shreyaspotnis/temperature_controller/README.md

# temperature_controller
A unipolar output temperature controller
