shreyaspotnis/temperature_controller/Bill of Materials.xlsx

Description | Digikey Part Number | Quantity | Footprint | Link | Parts
Resistors
10k Low Tempco Resistor | TNPU10.0KBACT-ND | 1 | "0603" | http://www.digikey.ca/product-detail/en/vishay-dale/TNPU060310K0BZEN00/TNPU10.0KBACT-ND/2238375 | R28
10k resistor, 1% | 311-10.0KHRCT-ND | 7 | "0603" | http://www.digikey.ca/product-detail/en/yageo/RC0603FR-0710KL/311-10.0KHRCT-ND/729827 | R13,R6,R7,R12,R14,R25,R26,
5.1k Low Tempco Resistor | RG16N5.1KWCT-ND | 2 | "0603" | http://www.digikey.ca/product-detail/en/susumu/RG1608N-512-W-T1/RG16N5.1KWCT-ND/600802 | R1,R2
499k | 311-499KHRCT-ND | 2 | "0603" | http://www.digikey.ca/product-detail/en/yageo/RC0603FR-07499KL/311-499KHRCT-ND/730214 | R3,R4
100k | 311-100KHRCT-ND | 4 | "0603" | http://www.digikey.ca/product-detail/en/yageo/RC0603FR-07100KL/311-100KHRCT-ND/729836 | R5,R23,R24,R27
1M | 311-1.00MHRCT-ND | 3 | "0603" | http://www.digikey.ca/product-detail/en/yageo/RC0603FR-071ML/311-1.00MHRCT-ND/729791 | R15,R19,R21
3k | 311-3.0KGRCT-ND | 1 | "0603" | http://www.digikey.ca/product-detail/en/yageo/RC0603JR-073KL/311-3.0KGRCT-ND/729701 | R9, R16
1k | 311-1.0KGRCT-ND | 3 | "0603" | http://www.digikey.ca/product-search/en?keywords=311-1.0KGRCT-ND | R17,R22,R29
511Ohm | 311-511HRTR-ND | 2 | "0603" | http://www.digikey.ca/product-detail/en/yageo/RC0603FR-07511RL/311-511HRTR-ND/727287 | R8,R18
9.09k | 311-9.09KHRCT-ND | 1 | "0603" | http://www.digikey.ca/product-detail/en/yageo/RC0603FR-079K09L/311-9.09KHRCT-ND/730365 | R20
0.5 Ohm Sense resistor | CSRN2512FKR500CT-ND | 1 | "2512" | http://www.digikey.ca/product-detail/en/stackpole-electronics-inc/CSRN2512FKR500/CSRN2512FKR500CT-ND/1788162 | R11
ICs
2.5V Reference | AD780ARZ-ND | 1 | 8-SOIC | http://www.digikey.ca/product-detail/en/analog-devices-inc/AD780ARZ/AD780ARZ-ND/619675 | U7
OP497 quad opamp picometer | OP497GSZ-ND | 2 | 16-SOIC | http://www.digikey.ca/product-detail/en/analog-devices-inc/OP497GSZ/OP497GSZ-ND/655707 | U1,U2
INA188 in-amp zero drift | 296-43151-1-ND | 1 | 8-SOIC | http://www.digikey.ca/product-detail/en/texas-instruments/INA188IDR/296-43151-1-ND/5724135 | U5
IRL540 | IRL540PBF-ND | 1 | TO220 | http://www.digikey.ca/product-detail/en/vishay-siliconix/IRL540PBF/IRL540PBF-ND/812025 | Q1
Connectors
Dual-BNC connector | ARF2136-ND | 1 | Custom | http://www.digikey.ca/product-detail/en/amphenol-rf-division/031-6576/ARF2136-ND/4037242 | P1
3 pin wire to board | ED2610-ND | 1 | Custom | http://www.digikey.ca/product-detail/en/on-shore-technology-inc/OSTTC032162/ED2610-ND/614559 | U3
2 pin wire to board | ED2580-ND | 2 | Custom | http://www.digikey.ca/product-detail/en/on-shore-technology-inc/OSTTA024163/ED2580-ND/614529 | U4, U6
Capacitors
0.1uF | 445-2514-1-ND | 10 | "0805" | http://www.digikey.ca/product-detail/en/tdk-corporation/C2012X8R1H104K125AA/445-2514-2-ND/927140 | C3,C5,C6,C7,C10,C11,C17,C18,C19,C20
1uF | 311-1372-1-ND | 5 | "0603" | http://www.digikey.ca/product-detail/en/yageo/CC0603ZRY5V7BB105/311-1372-1-ND/2103156 | C8,C13,C14,C15,C16
10uF | 490-6473-1-ND | 3 | "0805" | http://www.digikey.ca/product-detail/en/murata-electronics-north-america/GRM21BR61C106KE15K/490-6473-1-ND/3845670 | C1,C2,C12
330pF | 1276-1787-1-ND | 1 | "0603" | http://www.digikey.ca/product-detail/en/samsung-electro-mechanics-america-inc/CL10B331KB8NNNC/1276-1787-1-ND/3889873 | C4
Trimpots
100k | 490-2876-ND | 1 | Custom | http://www.digikey.ca/product-detail/en/bourns-inc/PV36W104C01B00/490-2876-ND/666503 | RV2
10k | 490-2875-ND | 2 | Custom | http://www.digikey.ca/products/en?keywords=PV36W103C01B00 | RV3,RV4
Others
10k 10 turn, Vishay spectrol | 534B1103JC-ND | 1 | Custom | http://www.digikey.ca/product-detail/en/vishay-spectrol/534B1103JC/534B1103JC-ND/1287411 | RV1
Throughhole right angle toggle switch | EG2362-ND | 3 | Custom | http://www.digikey.ca/product-search/en?keywords=100SP1T2B4M6QE | S1, S2, S5
DIP Switch SDPT | 563-1022-2-ND | 2 | Custom | http://www.digikey.ca/product-detail/en/copal-electronics-inc/CJS-1200TB/563-1022-2-ND/948333 | S3, S4
Enclosure
Box, Aluminum 4.724" L x 4.055" W (119.99mm x 103.00mm) X 2.087" (53.00mm) | HM974-ND | 1 |  | http://www.digikey.ca/product-detail/en/hammond-manufacturing/1455N1201/HM974-ND/460173
