shreyaspotnis/temperature_controller/temperature_controller.pdf

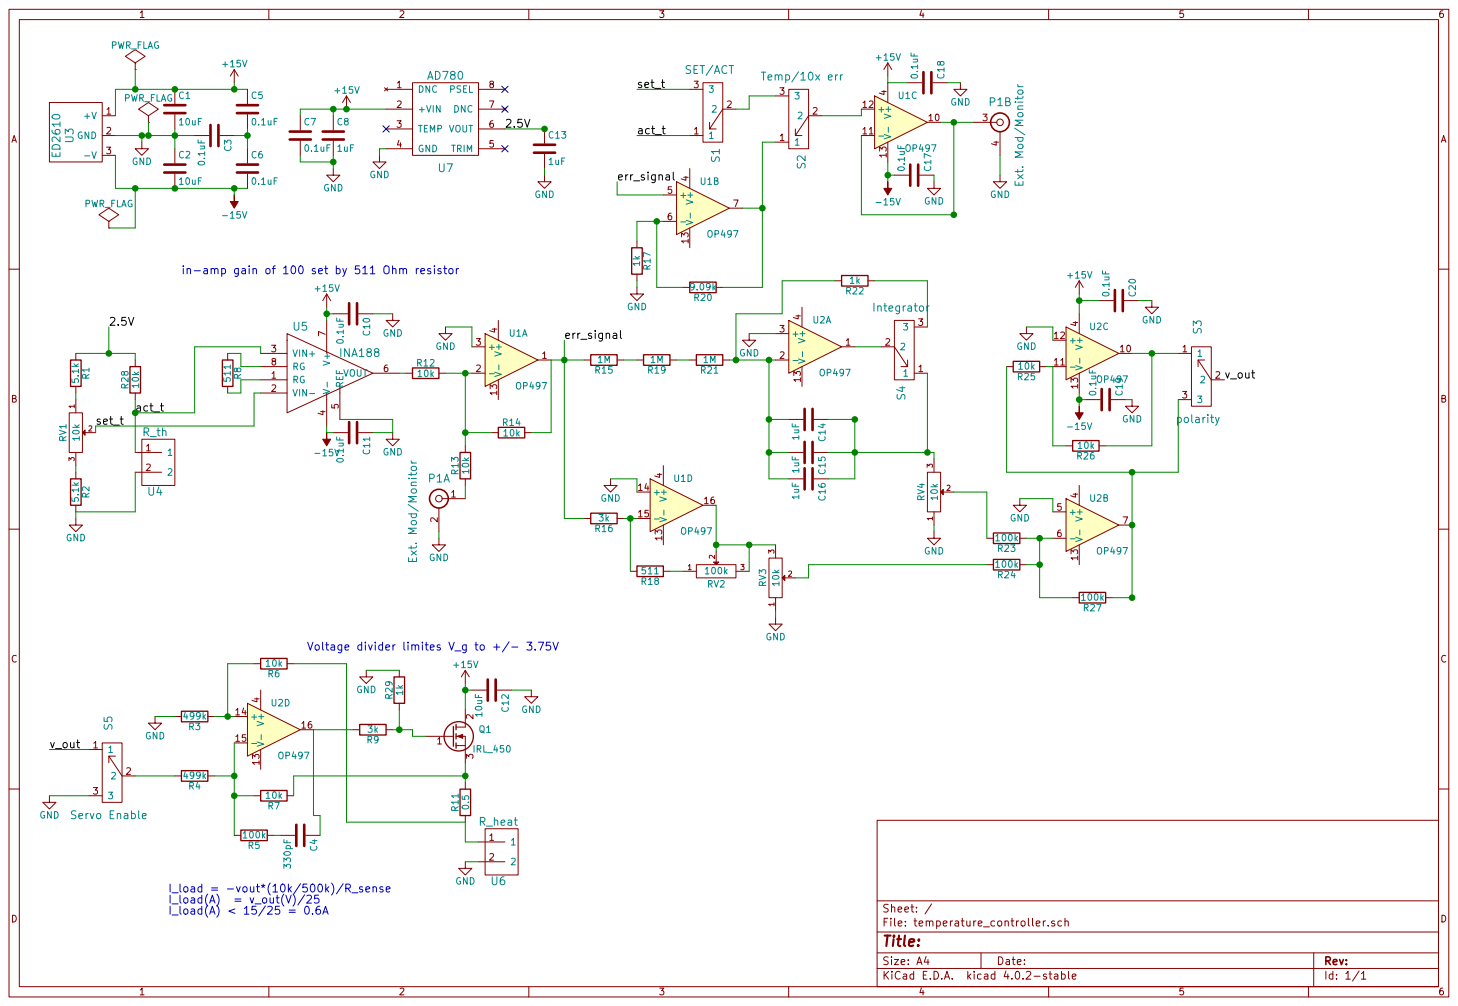
[picture p1: page 1]

3 RV1 10k DNC 1 +VIN 2 TEMP 3 GND 4 TRIM 5 VOUT 6 DNC 7 PSEL 8 U7 AD780

4 P1B Ext. Mod/Monitor GND

2 P1A Ext. Mod/Monitor GND

Voltage divider limites V_g to +/- 3.75V
