shreyaspotnis/temperature_controller/temperature_controller.kicad_pcb

## KiCad design temperature_controller.kicad_pcb (2017-04-05)

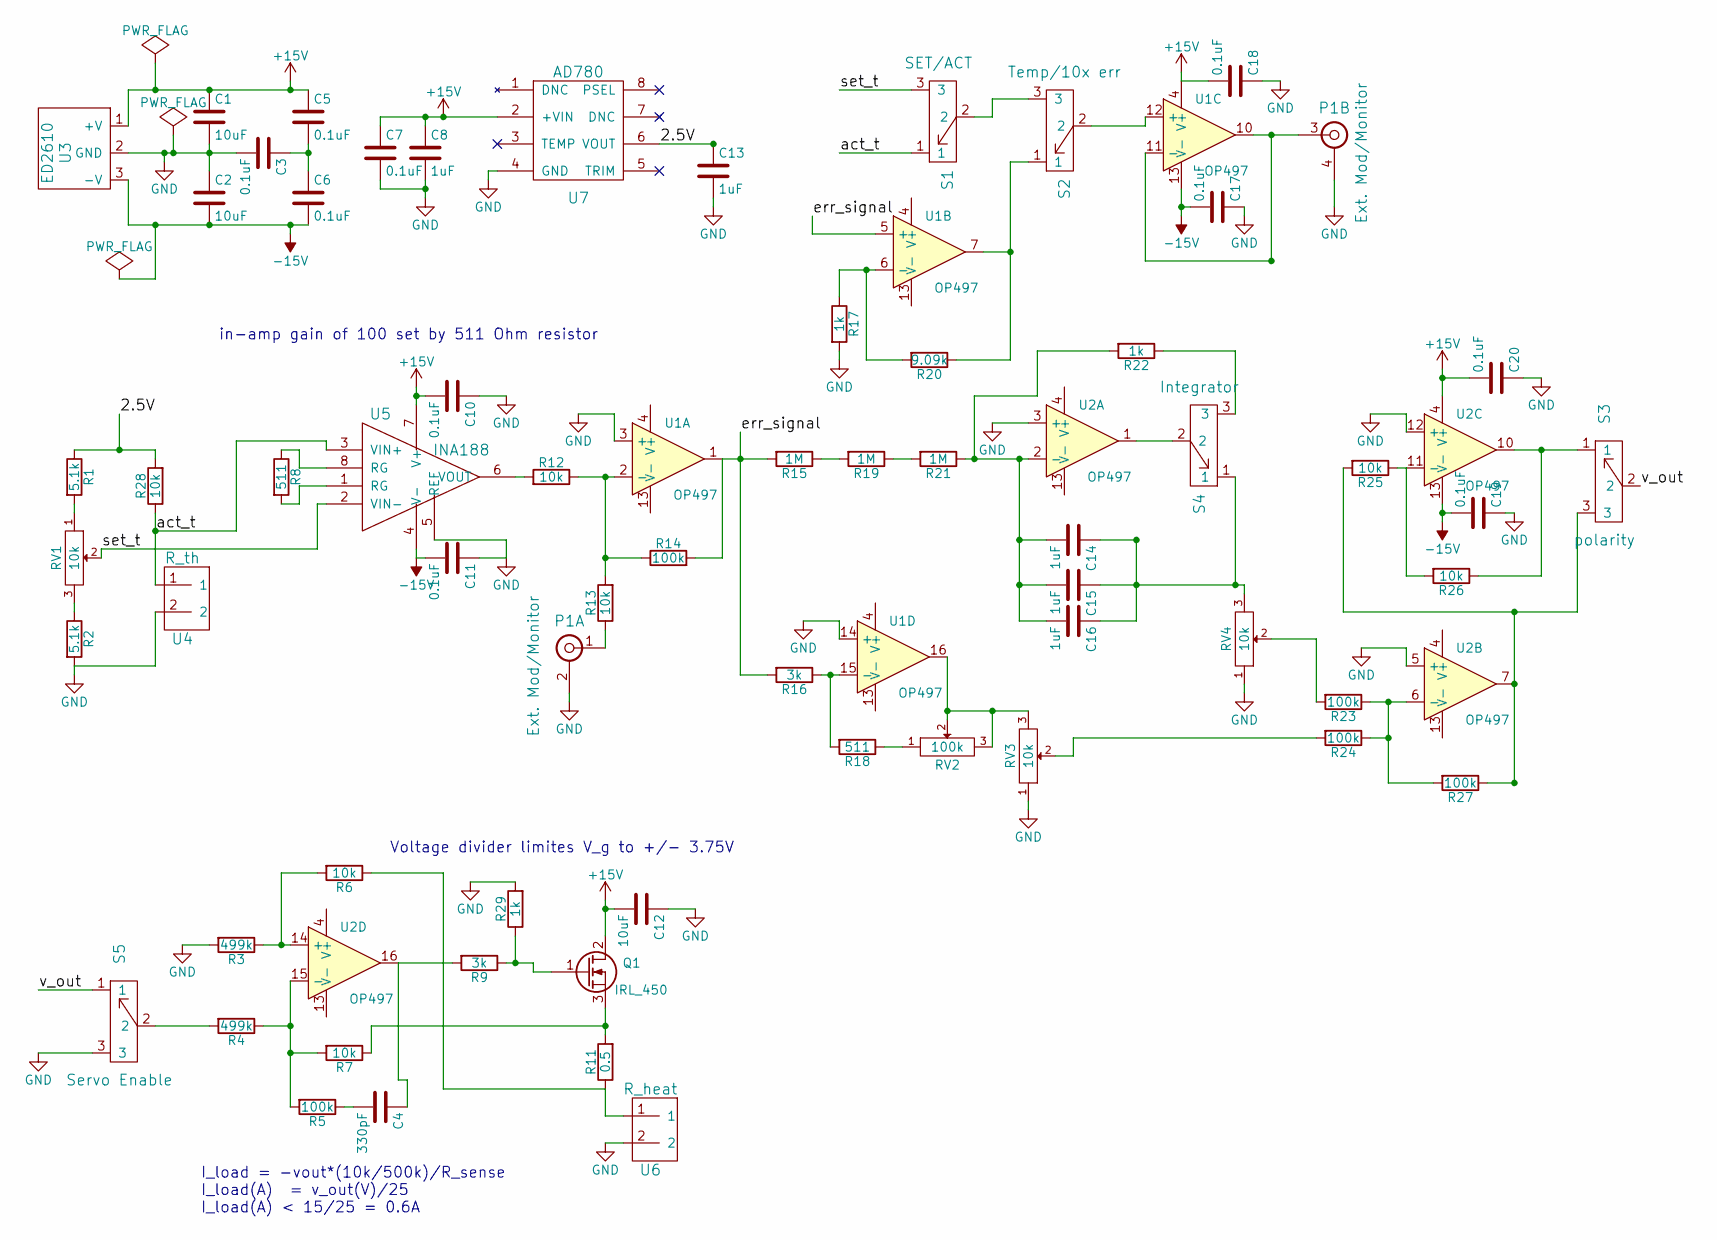
[picture p2: schematic temperature_controller.sch]

Parts:
C1, C2, C12: 10uF; C_0805_HandSoldering
C3, C5, C6, C7, C10, C11, C17, C18, C19, C20: 0.1uF; C_0805_HandSoldering
C4: 330pF; C_0603_HandSoldering
C8, C13, C14, C15, C16: 1uF; C_0603_HandSoldering
P1: Ext. Mod/Monitor; Dual-BNC-ARF2136
Q1: IRL_450; TO-220_Neutral123_Vertical
R1, R2: 5.1k; R_0603_HandSoldering
R3, R4: 499k; R_0603_HandSoldering
R5, R14, R23, R24, R27: 100k; R_0603_HandSoldering
R6, R7, R12, R13, R25, R26, R28: 10k; R_0603_HandSoldering
R8, R18: 511; R_0603_HandSoldering
R9: 3k; C_0603_HandSoldering
R11: 0.5; R_2512_HandSoldering
R15, R19, R21: 1M; R_0603_HandSoldering
R16: 3k; R_0603_HandSoldering
R17, R22, R29: 1k; R_0603_HandSoldering
R20: 9.09k; R_0603_HandSoldering
RV1: 10k; VishaySpectrol536
RV2: 100k; Bourns-PV36W104C01B00-trimmer
RV3, RV4: 10k; Bourns-PV36W104C01B00-trimmer
S1: SET/ACT; SPDT-Horizontal
S2: Temp/10x err; SPDT-Horizontal
S3: polarity; CJS-1200TB-SPDT
S4: Integrator; CJS-1200TB-SPDT
S5: Servo Enable; SPDT-Horizontal
U1, U2: OP497; SOIC-16W_7.5x10.3mm_Pitch1.27mm
U3: ED2610
U4: R_th; ED2580
U5: INA188; SOIC-8_3.9x4.9mm_Pitch1.27mm
U6: R_heat; ED2580
U7: AD780; SOIC-8_3.9x4.9mm_Pitch1.27mm

Connections:
+15V: C1.1, C5.1, C7.1, C8.1, C10.2, C12.2, C18.2, C20.2, Q1.2 (D), U1.4 (V+), U2.4 (V+), U3.1 (+V), U5.7 (V+), U7.2 (+VIN)
-15V: C2.2, C6.2, C11.2, C17.2, C19.2, U1.13 (V-), U2.13 (V-), U3.3 (-V), U5.4 (V-)
/2.5V: C13.1, R1.1, R28.2, U7.6 (VOUT)
/act_t: R28.1, S1.1, U4.1, U5.3 (VIN+)
/err_signal: R14.2, R15.2, R16.2, U1.1, U1.5 (+)
/set_t: RV1.2, S1.3, U5.2 (VIN-)
/v_out: S3.2, S5.1
GND: C1.2, C2.1, C3.2, C7.2, C8.2, C10.1, C11.1, C12.1, C13.2, C17.1, C18.1, C19.1, C20.1, P1.2, P1.4, R2.2, R3.2, R17.2, R29.2, RV3.1, RV4.1, S5.3, U1.3 (+), U1.14 (+), U2.3 (+), U2.5 (+), U2.12 (+), U3.2 (GND), U4.2, U5.5 (REF), U6.2, U7.4 (GND)
unnamed: C3.1, C5.2, C6.1
unnamed: C4.1, R9.2, U2.16
unnamed: C4.2, R5.1
unnamed: C14.1, C15.1, C16.1, RV4.3, S4.1
unnamed: C14.2, C15.2, C16.2, R21.1, R22.2, U2.2 (-)
unnamed: P1.1, R13.1
unnamed: P1.3, U1.10, U1.11 (-)
unnamed: Q1.1 (G), R9.1, R29.1
unnamed: Q1.3 (S), R7.1, R11.2
unnamed: R1.2, RV1.1
unnamed: R2.1, RV1.3
unnamed: R3.1, R6.2, U2.14 (+)
unnamed: R4.1, R5.2, R7.2, U2.15 (-)
unnamed: R4.2, S5.2
unnamed: R8.1, U5.8 (RG)
unnamed: R8.2, U5.1 (RG)
unnamed: R6.1, R11.1, U6.1
unnamed: R12.1, R13.2, R14.1, U1.2 (-)
unnamed: R12.2, U5.6 (VOUT)
unnamed: R15.1, R19.2
unnamed: R16.1, R18.2, U1.15 (-)
unnamed: R17.1, R20.2, U1.6 (-)
unnamed: R18.1, RV2.1
unnamed: R19.1, R21.2
unnamed: R20.1, S2.1, U1.7
unnamed: R22.1, S4.3
unnamed: R23.1, R24.1, R27.2, U2.6 (-)
unnamed: R23.2, RV4.2
unnamed: R24.2, RV3.2
unnamed: R25.1, R26.2, U2.11 (-)
unnamed: R25.2, R27.1, S3.3, U2.7
unnamed: R26.1, S3.1, U2.10
unnamed: RV2.2, RV2.3, RV3.3, U1.16
unnamed: S1.2, S2.3
unnamed: S2.2, U1.12 (+)
unnamed: S4.2, U2.1

Notes on the sheet:
in-amp gain of 100 set by 511 Ohm resistor
I_load = -vout*(10k/500k)/R_sense I_load(A) = v_out(V)/25 I_load(A) < 15/25 = 0.6A
Voltage divider limites V_g to +/- 3.75V

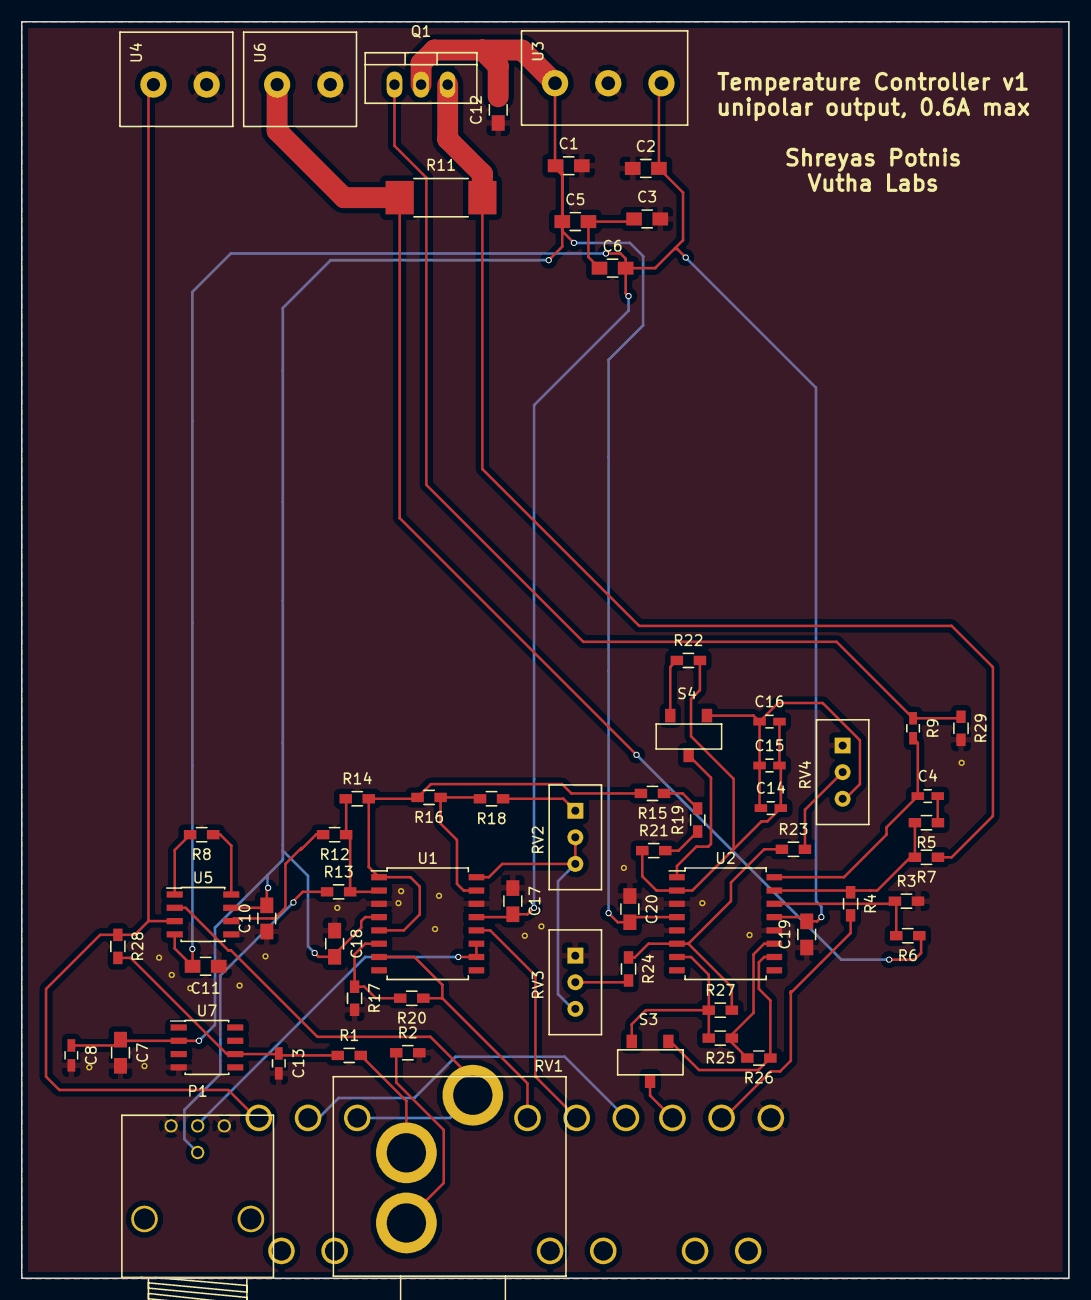
[picture p3: board temperature_controller.kicad_pcb from above]

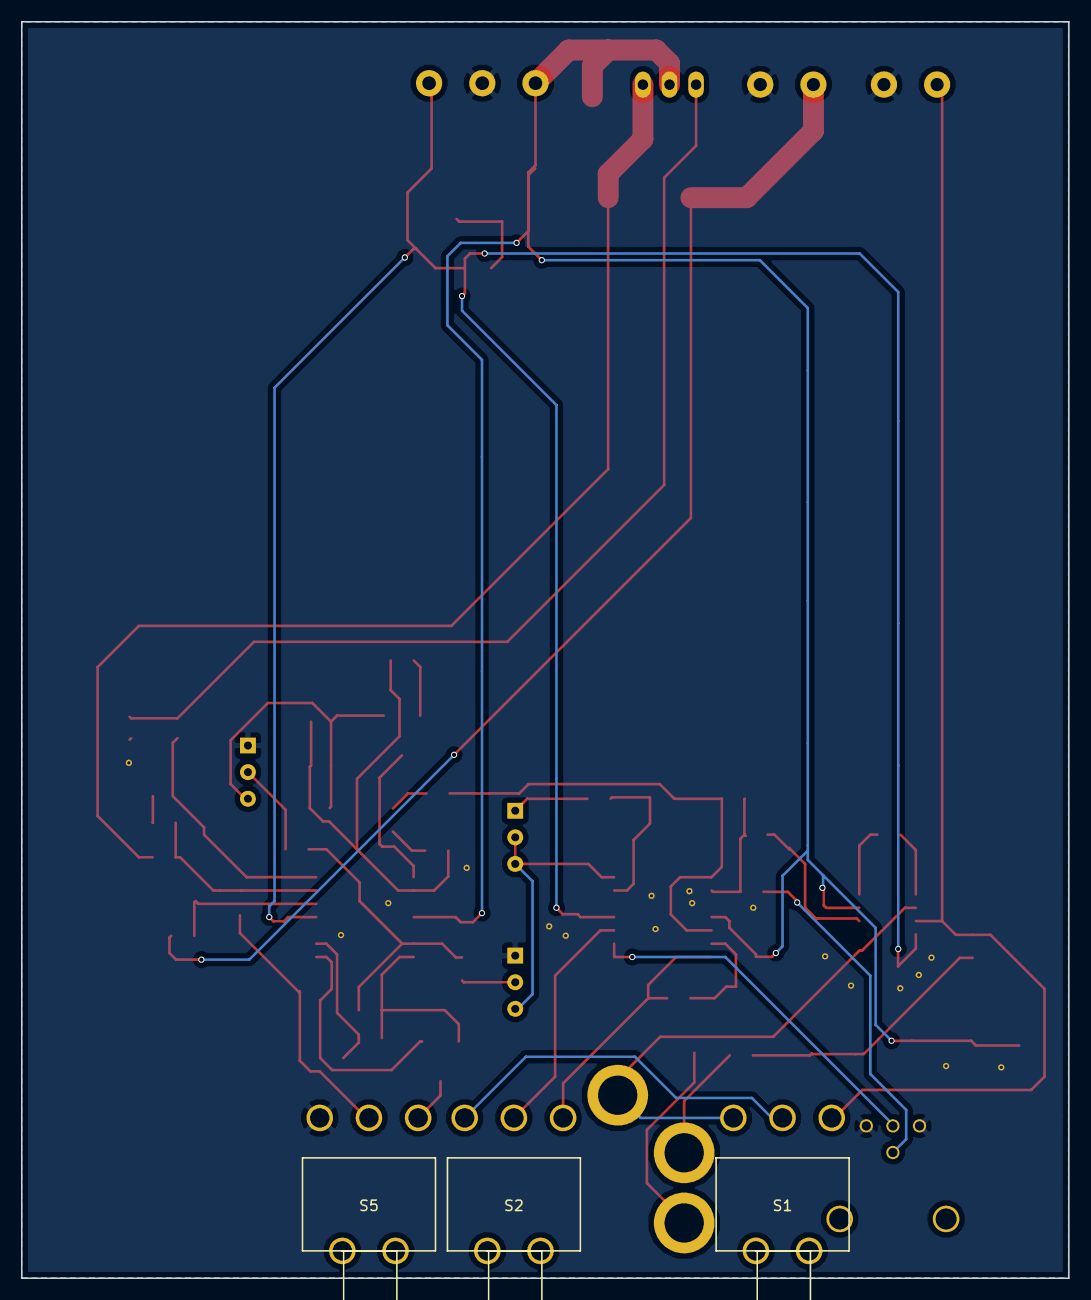
[picture p4: board temperature_controller.kicad_pcb from below]

Board: 2 copper layers, 100.0 x 120.0 mm, 65 parts (3 on the bottom side), 44 nets.
