shreyaspotnis/temperature_controller/(commit log)

2017-01-06 Design almost finished
    [temperature_controller.kicad_pcb, temperature_controller.sch]
2017-04-05 final design
    [temperature_controller.kicad_pcb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]
2017-04-05 Added bill of materials
    [Bill of Materials.xlsx]
